Ecam-Eurobot/Eurobot-2017/doc/assets/Capture d’écran 2017-05-08 à 02.06.36.png

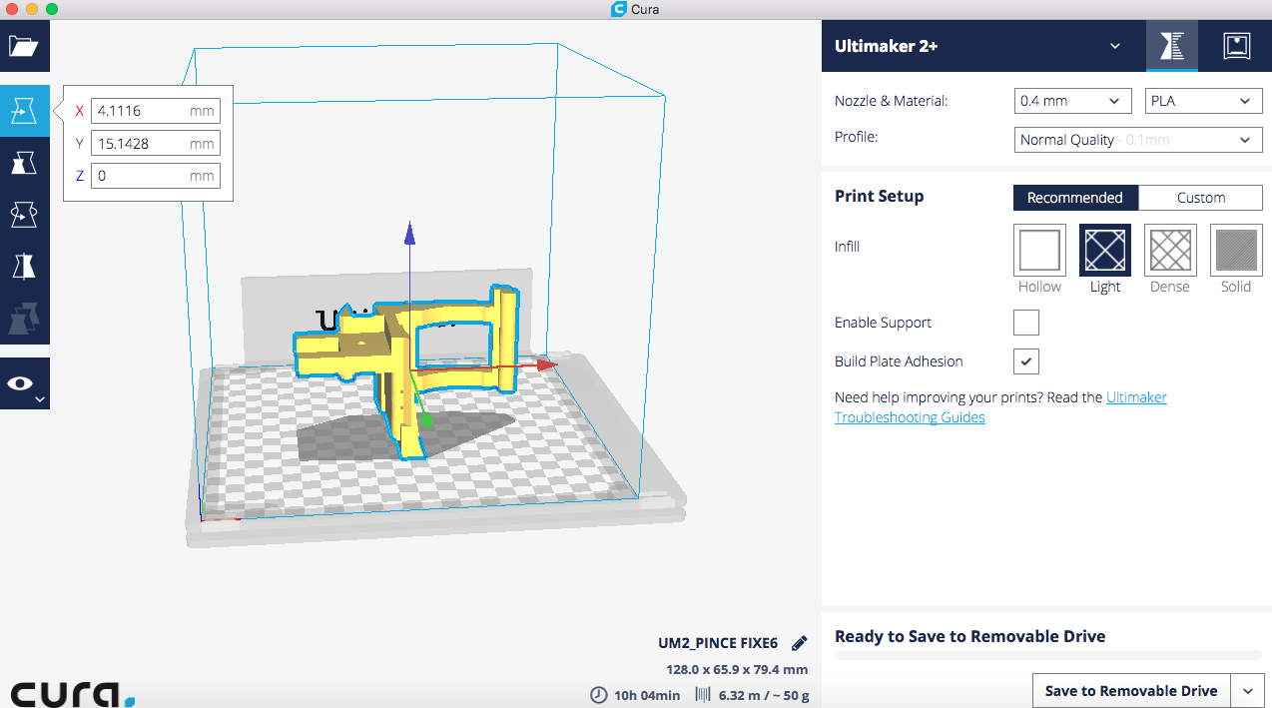
doc/assets/Capture d’écran 2017-05-08 à 02.06.36.png
