Ecam-Eurobot/Eurobot-2017/(threads)

Thread 5 (2017-02-02):

Interface I2C capteurs ultrasons

azerupi, 2017-02-02:
Il faut définir une interface (protocole / API) pour que la Raspberry Pi et l'Arduino, qui communiquent en I2C, puisse se comprendre.

**Cahier des charges**
- Demander la mesure de tout les capteurs en une fois
- Demander la mesure d'un capteur spécifique
- Si le capteur demandé n'existe pas, renvoyer une séquence d'erreur que la Raspberry peut comprendre
- Demander d'énumérer les capteurs qui existent
- *Autres?*

### Proposition

La Raspberry Pi envoie une instruction sur un byte contentant 2 parties codées sur 4 bits:
- La commande
- L'index du capteur (si applicable)

**commandes**
```
0001 xxxx        demander la mesure du capteur `xxxx`
0010 0000        demander la mesure de tous les capteurs
0011 0000        demander d'énumérer tous les capteurs
```

L'Arduino renvoie:
1. Une distance en cm (`int 16 bits`). On sépare le int en 2 bytes pour l'envoyer par I2C et puis on le reassemble sur la Pi. Si une erreur survient (e.g. le capteur n’existe pas) on renvoie `0xFFFF`.
2. n-fois 2 bytes (une fois par capteur)
3. n-fois 1 byte avec l'indice du capteur. On pourrait coder 2 capteurs par byte, mais alors il faut gérer le cas d'un nombre impaire de capteurs.

Ceci n'est qu'une proposition, la discussion est ouverte pour d'autres alternatives.

charlesvdv, 2017-02-02:
J'ai quelque pensée en plus à ajouter.

Valables pour toutes les communications I2C:
- Est-ce que la communication est 100% sans erreur ? (Il faudrait essayer d'envoyer des grosses séquences de bytes pour voir si on reçoit bien tout correctement) et donc ajouter un CRC ou un code de parité...

- N'enverrions nous pas la taille du message également dans le premier byte pour faciliter la gestion du module I2C sur la raspberry? (Pour avoir un tronc commun avec toutes les interfaces?)

- La communication sera d'office synchrone ? Aussi nn il faudrait réfléchir à ajouter la commande envoyée dans la requête.

Valables pour US:
- Lors de l'énumération de toutes les données des capteurs, ne faudrait il pas donner d'abord l'id du capteur pour ensuite mettre la valeur. On ajoute un peu d'overread mais on gagne en resiliance.

- C'est peut-être overkill mais possibiliter de demander certains capteurs genre que ceux avant ou arrière. Je sais pas si il y a un grand intérêt mais c's mieux d'y réfléchir mnt qu'après.

Aussi nn j'aime bien l'idee générale.

azerupi, 2017-02-02:
> Est-ce que la communication est 100% sans erreur ?

100% je ne sais pas. Mais, si je ne me trompe pas un appareil doit envoyer un bit de bonne réception ACK une fois un message reçu. Jusqu'à présent les seuls problèmes qu'on a eu avec l'I2C c'est des timeouts qui résultent en un exception dans la PI quand il y avait des mauvaises connexions ou que l'Arduino ne renvoyait pas ce qu'il fallait.

> N'enverrions nous pas la taille du message également dans le premier byte pour faciliter la gestion du module I2C sur la raspberry?

On pourrait, mais dépendant de ce qu'on doit envoyer ce n'est pas toujours nécessaire. Par exemple, pour les capteurs ultrason on a fini par demander une fois le nombre de capteurs présent à l'allumage et du coup on sait combien de bytes attendre en retour pour chaque requête. Ils faudra réfléchir par rapport aux besoins des autres modules.

> La communication sera d'office synchrone ?

Par synchrone tu veux dire que l'ordre est préservé? Alors oui, on écrit byte par byte sur le bus et pour chaque byte l’esclave envoi un bit de bonne réception.

>Nous devrions aussi ajouter une information sur l'erreur de l'arduino vu que la raspberry est la seul à logger les erreurs/warnings.

C'est pas une mauvaise idée, dans ce cas il faudra un peu réfléchir à ce qu'on a besoin précisément parce que je pense que le système décrit ci-dessus ne pourra pas le gérer.

> Lors de l'énumération de toutes les données des capteurs, ne faudrait il pas donner d'abord l'id du capteur pour ensuite mettre la valeur.

Quand on demande les mesures de tous les capteurs ont les reçoit dans l'ordre, donc envoyer l'ID n'as pas trop d’intérêt dans le setup actuel.

> C'est peut-être overkill mais possibiliter de demander certains capteurs genre que ceux avant ou arrière.

Je pense pas que ça vaut la peine de le gérer dans l'arduino, vu que la Pi peut demander les résultats d'un capteur précis il suffit de rajouter une méthode dans le code Python qui demande plusieurs capteurs précis.

JonathanPetit, 2017-02-02:
> Est-ce que la communication est 100% sans erreur ?

Il faudra faire attention lors du placement de la raspberry et de l'arduino dans la partie mécanique parce que si je me trompe pas l'i2c est fort perturbé par le bruit. Il faudra donc pas que la liaison entre les 2 soit trop longue.

> La communication sera d'office synchrone ?

Si je me trompe pas la communication i2c est d'office synchrone, en tout d'après ce que j'ai pu lire sur la différente documentation rencontré lorsque l'on tester l'i2c.

charlesvdv, 2017-02-03:
> Mais, si je ne me trompe pas un appareil doit envoyer un bit de bonne réception ACK une fois un message reçu.

Le fait qu'on envoie/reçoit un signal ACK ne signifie pas que les bits n'ont pas été modifié par la ligne de transmission. Il signifie juste que le récepteur a reçu qq chose.

Une autre chose à rajouter au protocole serait un simple ```ping pong``` pour être sûr que l'arduino est connectée.

Une chose où l'on devrait faire attention serait d'avoir un tronc commun important entre les différents protocoles I2C.

azerupi, 2017-02-04:
>Une autre chose à rajouter au protocole serait un simple ping pong pour être sûr que l'arduino est connectée.

Si elle n'est pas connectée, la librairie SMBus renvoie une exception, donc pas besoin de faire un ping. Par contre il faudra bien gérer les exceptions pour éviter que notre robot plante parce qu'il y à un mauvais branchement...

> Une chose où l'on devrait faire attention serait d'avoir un tronc commun important entre les différents protocoles I2C.

Dans #4 on a déjà commencé à faire exactement ça. En fonction des besoins des autres modules on pourra regrouper d'autres fonctionnalités sous la classe `I2C` pour éviter de se répéter.

Thread 6 (2017-02-07):

Interface I2C gestion moteur

charlesvdv, 2017-02-07:
Ce qu'on a besoin comme action:
- tourner à gauche de X degrés
- tourner à droite de X degrés
- avancer de X cm
- reculer de X cm
- arreter les moteurs
- demander le déplacement déjà effectuer
- demander si action finie ou pas

On a pas de précision de plus d'un cm donc ca sert à rien d'envoyer des données en dizaines de mm ou memes en minimètres. On aura donc besoin de 8bits pour avoir 256cm max (résonnable sachant que le plateau fait 1m*2m).

On peut donc faire un peu comme #5 mais la commande sera sur 8bits.

L'info sur le déplacement déjà effectué devra retourner 2 bytes. Un pour la roue gauche et un pour la roue droite.

@azerupi d'autres idées ?

azerupi, 2017-02-07:
>On a pas de précision de plus d'un cm

Même les odomètres?

Sinon au niveau des actions, ça me semble bien. Il y à juste une chose très importante qui manque, c'est la régulation de la vitesse :wink:

Soit on permet d'envoyer la vitesse comme paramètre pour chaque commande qui occasionne un déplacement, soit on rajoute une commande qui permet de changer la vitesse pour les commandes qui vont suivre.

Je dirais que les actions listés ci-dessus sont le stricte minimum à supporter, mais si on est chaud il y à moyen d'en ajouter des plus complexes qui permettraient d'avoir plus de mobilité et un déplacement plus fluide et donc plus rapide. On pourrait penser à:

- **Tourner en avançant**, au lieu d'avancer, s’arrêter pour tourner, avancer, s'arrêter à nouveau pour tourner, ... ça pourrait être plus efficace de pouvoir suivre une trajectoire courbe sans s’arrêter. Pour ça on devrait ralentir une roue par rapport à l'autre et bien réguler les vitesses.
- **Tourner autour d'une roue**, au lieu de tourner autour du centre, on pourrait vouloir tourner autour d'une des roues. Donc au lieu d'avoir les deux roues qui tournent dans un sens opposé, on aurait une roue à l'arrêt et une roue en mouvement.

Dernière chose, mais peut-être que je m'avance un peu trop, il faudra faire attention aux "accélération instantanées". Les moteurs sont vraiment costaud, si on passe de 0 à 100% en un coup on risque de faire basculer le robot. Je pense qu'il faudra faire en sorte que l'accélération se fasse progressivement.

charlesvdv, 2017-02-07:
> Même les odomètres?

D'après M. Marchand, une précision de 1cm est déjà très bien malheureusement parce qu'on doit compter aussi sur la précision des moteurs, etc

> Soit on permet d'envoyer la vitesse comme paramètre pour chaque commande qui occasionne un déplacement, soit on rajoute une commande qui permet de changer la vitesse pour les commandes qui vont suivre.

Je pense pas que ce soit utile vu que l'on a toujours comme but d'aller le plus rapidement possible. Par contre une commande spéciale pour passer la bascule pourrait etre intéressante.

> Dernière chose, mais peut-être que je m'avance un peu trop, il faudra faire attention aux "accélération instantanées". Les moteurs sont vraiment costaud, si on passe de 0 à 100% en un coup on risque de faire basculer le robot. Je pense qu'il faudra faire en sorte que l'accélération se fasse progressivement.

C'est le but de l'arduino avec la [régulation PID](https://en.wikipedia.org/wiki/PID_controller) que l'on doit incorporer.

> Je dirais que les actions listés ci-dessus sont le stricte minimum à supporter, mais si on est chaud il y à moyen d'en ajouter des plus complexes qui permettraient d'avoir plus de mobilité et un déplacement plus fluide et donc plus rapide.

D'après M. Marchand, aucune équipe de l'ECAM n'a jamais implémenté ca. Ca risque d'etre fort compliqué sachant que l'on a besoin du rayon de courbure de la trajectoire. Cette curbure pourrait etre non constante, etc... A voir mais pour moi il y a bcp plus important.

azerupi, 2017-02-07:
Oui, clairement il y à plus important. Je ne voulait pas dire qu'il fallait l'implémenter, mais plutôt qu'on pouvait structurer le code de façon à pouvoir l'ajouter plus tard, au cas ou. Même si on ne le fait pas cette année, on pourrait reprendre le code l'année prochaine et l'étendre par exemple. Autant pas s'imposer des limites quand elle ne sont pas nécessaires :)

> Je pense pas que ce soit utile vu que l'on a toujours comme but d'aller le plus rapidement possible. Par contre une commande spéciale pour passer la bascule pourrait etre intéressante.

Je suis pas tout à fait d'accord, en approchant des "destinations cibles" on voudra probablement ralentir pour être plus précis. On en aura également besoin pour la bascule et peut-être si jamais on tombe sur un obstacle imprévu (e.g. le robot adverse). Autant l'ajouter, je ne pense pas que ça ajoute beaucoup de complexité.

Thread 7 (2017-02-07):

Structure du programme raspi

charlesvdv, 2017-02-07:
Discussion pour la structure du code de RaspberryPi.

On doit gérer différentes parties:
- [x] une classe d'abstraction d'I2C (en cours via #4)
- [x] une classe qui gère les capteurs US (en cours via #4)
- [ ] une classe qui fait l'interface entre la commande et l'arduino *moteur*
- [ ] une classe de Logging
- [ ] une classe qui gère l'arduino *Cinématique* (action spécial faite par le robot genre ramasser des modules lunaires, funny actions, ramasser le balle lunaire??)(ou 2 classes pour le grand robot et le petit robot, peut etre plus facile)
- [ ] une classe qui gère le robot avec toutes les abstractions et les stratégies (on verra ca plus tard...)
- [ ] une classe qui gére la représentation des objets sur le terrain, la position du robot, ... Ca permettera d'avoir une abstraction sur le fait qu'on soit ou pas d'un coté ou d'un autre, etc
- [ ] une classe *PathFinder* pour calculer son chemin par rapport à la carte et sa position

(les taches sont mises plus ou moins en ordre d'importance)

Qq'un a encore une idée?

azerupi, 2017-02-07:
>ou 2 classes pour le grand robot et le petit robot, peut etre plus facile

Comme on est sur une machine linux, on peut utiliser une variable d’environnement pour choisir si on est sur le grand ou le petit robot. Alors on peut faire un seul code qui gère tout et en fonction de la Raspberry sur laquelle on l’exécute il changera son comportement. Je ne suis pas 100% sur que le code sera plus propre que si on scinde le programme en deux, mais je pense que c'est une piste à explorer.

> une classe qui gère l'arduino Cinématique

Je pense qu'il faut une classe par module. Par exemple, pour le gros robot, il aura un système pour attraper les cylindres, un pour les déposer et les retourner. Il est possible qu'on décide que ce soit trois modules séparés ou un seul module unique (à décider quand on aura une idée plus concrete). Mais pour moi, il faut au moins une classe par Arduino (module) qui crée une abstraction pour l'envoie de commande par I2C. Après, il y à moyen de grouper plusieurs de ces classes qui sont sensés fonctionner ensembles pour créer une abstraction de plus haut niveau par dessus.

Dans un premier temps, je pense qu'on doit se concentrer sur le code qui gère le hardware et éviter de trop réfléchir au code pour l'intelligence. Une fois que le hardware est bien représenté dans le code on pourra déjà tester le robot (si la partie mécanique et électronique suit).

charlesvdv, 2017-02-07:
> Comme on est sur une machine linux, on peut utiliser une variable d’environnement pour choisir si on est sur le grand ou le petit robot.

J'y avais aussi pensé aussi.

> Je pense qu'il faut une classe par module.

Je suis bien d'accord mais certaines actions de la cinématique ne demande pas la raspberry pi. La plus part du temps, la cinématique pensée ne requierera pas la raspberrypi.

> je pense qu'on doit se concentrer sur le code qui gère le hardware et éviter de trop réfléchir au code pour l'intelligence.

Ce n'est qu'une piste de rélfexion pour pouvoir démarrer le code raspberry pi plus rapidement comme le projet va avancer très vite maintenant que l'on est tous présents.

azerupi, 2017-02-08:
> une classe de Logging

J'imagine qu'on utilisera le module de logging standard de python. Probablement pas besoin de classe personnalisée.

Thread 8 (2017-02-08):

Fonctions communes arduino pour I2C

azerupi, 2017-02-08:
Je pense que, comme pour la Pi, il serait intéressant de mettre en commun certaines fonctions pour la gestion de l'I2C pour les arduinos. Comme les arduinos sont plus bas niveau et spécifique, on n'as pas nécessairement besoin d'une abstraction tel que sur la Pi. Mais les fonctions pour la construction / déstructuration des messages I2C pourrait servir pour la plupart des modules.

Thread 11 (2017-02-21):

Protocole I2C pour la gestion des servos

gaeta1611, 2017-02-21:
# Cahier de charge

- Envoyer à quel servo veut-on parler
- Envoyer une action pour ce servo (open/close - up/down)
- Demander si le déplacement est fini ou pas
- Arrêter le mouvement des servos
- Autre ?

Besoin de 7-8 bits (à définir) pour envoyer l'angle (valeur entre 0 et 180, mais jusque 180 vraiment nécessaire ?).

Besoin de 2 bits pour définir à quel servo on parle. (3-4 servo différents maximum)

Reste des actions à définir.

Thread 13 (2017-02-22):

UML Raspberry

JonathanPetit, 2017-02-22:
Uml complet du projet eurobot 2017. Réfléchis par Charles et moi-même.
Suggestions ou corrections dites le nous.
@azerupi Qu'en penses-tu?

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

azerupi, 2017-02-23:
En reprenant les classes que nous avons déjà pour les modules I2C, personellement je commencerais par étendre comme ceci:

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

L'idée c'est d'avoir une classe `Robot` qui contrôle le robot à un haut niveau (éventuellement cette classe pourrait aussi avoir la routine principale, e.g. `run`). Cette classe contiendrait les différents modules qu'on à implémenté (capteurs, moteurs, pinces, ...) et fournit les méthodes de plus haut niveau.

Il contiendrait également une classe `Map` qui gère la position des différents obstacles et le pathfinding. Je pense qu'un map en tant qu'array 2D va être beaucoup trop coûteux. Il y à moyen de fortement s'inspirer des algorithmes et représentations utilisés pour les jeux. J'avais pensé à travailler simplement avec des listes de coordonnées cartésiennes et des calculs de "bounding box" pour les obstacles, mais il faut voir si ça fonctionne pour le pathfinding. Je pense qu'on peut ouvrir une issue rien que pour discuter de ça :yum:

charlesvdv, 2017-02-24:
En reparlant avec M. Marchand, les différentes stratégies n'ont pas d'interets si on a un algorithme de recherche de chemin performant pour faire volte-face si on a un obstacle. Du coup je suis d'accord que ca n'a pas d'intéret d'avoir des classes ```HighLevelAction``` et ```Strategy``` et mettre tout dans la classe ```Robot```.

Concernant la map, j'ai trouvé un truc vraiment pas mal... C's un [navigation meshes](http://theory.stanford.edu/~amitp/GameProgramming/MapRepresentations.html#navigation-meshes) qui représente les chemins possibles par un graphe. Ca a l'air d'être la solution la plus optimal.

On pourrait également avoir des meshes avec différentes zones pour par exemple limiter la vitesse(bascule), etc...

Je pense également qu'il serait intéressant d'avoir des nodes spécifiques comme atouts où il pourrait avoir des contraintes d'angles pour arriver sur l'objet, etc... et de laisser les obstacles abstraits (sans avoir de types précis) pour avoir plus de flexibilité pour les années d'après.

Thread 14 (2017-03-02):

raspberrypi info

charlesvdv, 2017-03-02:
*Ceci est une note. Ne pas la fermer*

#### IP
``` 172.17.33.174 ```
*Devrait normalement être statique... A voir*

#### login
```pi```

#### password
```raspberry```

Thread 17 (2017-03-31):

TODO grand robot pour concours!

charlesvdv, 2017-03-31:
## Mécanique
- [ ] funny action
- [ ] finir pince
- [ ] attacher la batterie
- [ ] modifier le belier + ajouter calle
- [ ] tester angle servo
- [ ] checker pente toboggan/pince
- [ ] finiolage
- [ ] fixer les US

## Code
- [ ] régul
- [ ] path finding
- [ ] gerer les actions haut level
- [ ] gerer les obstacles dynamiques
- [ ] mettre tout ensemble

Thread 29 (2017-05-18):

Année 2018 - Amélioration du système de contrôle des moteurs

AlexisTM, 2017-05-18:
Afin d'améliorer le système de contrôle des moteurs, il est nécessaire de calculer la position du robot plutôt que de penser qu'il est arrivé. Il y aura toujours un certain drift, mais il se fera probablement que peu sentir sur 90 secondes.

Voici l'idée:

Variables globales:

```
double distance_between_wheels = 0.4; // in meters
double x = 0;
double y = 0;
double th = 0; // Th est aussi appelé heading, théta ou yaw
unsigned long last_computation = micros();
```

Boucle de calcul, à executer toutes les N millisecondes

```
loop every N milliseconds
    double dt = (micros() -  last_computation)/1000000.0; // Temps depuis le calcul précédent

    // Vitesses en m/s
    double v_right = speed_right_wheel;
    double v_left = speed_left_wheel;

    // vx : Vitesse frontale - m/s
    // vy : Vitesse latérale - m/s
    // vth : Vitesse angulaire (autour de z) - radians/s
    double vx = (v_right + v_left)/2;
    double vy = 0
    double vth = (v_right - v_left) / distance_between_wheels;

    // Calculons la différence de position du robot (rotation)
    double delta_x = (vx * cos(th) - vy * sin(th)) * dt;
    double delta_y = (vx * sin(th) + vy * cos(th)) * dt;
    double delta_th = vth * dt;

    x = x + delta_x; // m
    y = y + delta_y; // m
    th = th + delta_th; // radians
```

Il est ensuite facile de calculer l'erreur de position et l'erreur angulaire pour la régulation.

```
ErrorX = setpoint.x - CurrentPosition.x
ErrorY = setpoint.y - CurrentPosition.y

# Error in forward direction of the robot
ErrorX_f = (cos(CurrentPosition.yaw) * ErrorX) + (sin(CurrentPosition.yaw) * ErrorY);
ErrorY_f = (-sin(CurrentPosition.yaw) * ErrorX) + (cos(CurrentPosition.yaw) * ErrorY);

ErrorTh = ErrorYaw = atan2( ErrorY_f, ErrorX_f)
```

charlesvdv, 2017-05-22:
@AlexisTM quel est l'avantage de cette approche par rapport à l'utilisation des odomètres qui sont pour l'instant sur le robot ? Ton idée est en fait de créer un système [INS](https://en.wikipedia.org/wiki/Inertial_navigation_system) ?

Les vitesses ```v_right``` et ```v_left``` ne peuvent être optenue *(pour l'instant en tout cas)* qu'en dérivant notre valeur de position sur un interval ```dt``` et ta manière consiste juste à intégré ces vitesses pour avoir la position. Nous revenons donc à notre point de départ et vu que la régulation change toutes les ```10ms``` les consignes de vitesse, cela signifie que l'on va perdre en précision dans notre positionnement.

AlexisTM, 2017-05-22:
C'est exactement ça. Tu utilises les odomètres pour déterminer les vitesses de chaque roue et obtenir la position.

En effet, il y a un drift, qui est inévitable, mais au final, tu gagneras en précision. En effet, en ne se basant que sur les odomètres, tu as une bonne précision localement mais globalement tu perds beaucoup de précision en "estimant être arrivé". Je te propose très simplement de mettre ce code côte à côte avec la régulation actuelle et observe le drift de la position. Sur 90 secondes et de si petites distances, ce sera minime.

De plus, réaliser la régulation de cette façon permet de faire un fusion de senseurs plus simple, par exemple en mettant un IMU et en utilisant un [Extended Kalman Filter](https://github.com/cra-ros-pkg/robot_localization)

Sur l'Arduino, la régulation bas niveau reste primordiale afin d'obtenir une vitesse correcte sur chacun des moteurs.

AlexisTM, 2024-10-28:
Outdated.

Closed 2024-10-28.
