Ecam-Eurobot/Eurobot-2017/(commit log)

2017-02-01 First design to abstract I2C comm behind a class
2017-02-02 Improve I2C abstraction
2017-02-03 [WIP] first arduino code for ultrason capteur
2017-02-08 Resolve bugs and format arduino code
    [i2c.py, range_sensors.py, us_sensors.ino]
2017-02-09 Ajout du rapport de l'année passée dans la doc.
2017-02-10 Fix errors in the python code
    [i2c.py, range_sensors.py]
2017-02-14 Controle basique des moteurs
2017-02-14 Ajout interface moteur pour la raspberrypi
2017-02-14 Implementation I2C communication
2017-02-16 fix motor control
2017-02-16 move motors.ino
2017-02-16 Fixe du array non valide
    [motors.ino]
2017-02-17 add motor abstraction
2017-02-17 fix compilation error for motors
    [motor.cpp, motor.h, motors.ino]
2017-02-17 add regulation for the motors
2017-02-19 finish regulation and Arduino I2C communication part
2017-02-20 cleanup and update raspberrypi code
    This commit marks also the first lead regulation working!
2017-02-21 Adding Dynamixel/servo ino code and librairy
2017-03-15 fix comments from @bluebeel
    mostly fix for const/constexpr
    [motor.cpp, motor.h, regulation.h]
2017-03-16 fix left right mismatch
    [motors.ino]
2017-03-18 Final version of Arduino servo
2017-03-18 Trouble shooting I2C dynamixel
2017-03-18 Adding the 2 others servo : Stack and push
2017-04-07 Finale version of Arduino SERVO
2017-04-07 Change servo push parameters
2017-04-12 handle OSError when I2C bus is busy.
2017-04-12 fix maxspeed motors control
    [motor.cpp, motor.h, regulation.cpp]
2017-04-12 correct pin for encoder
    [motors.ino]
2017-04-12 move us_sensors in his own folder
    the arduino IDE keep moving the file in his own folder so be it!
2017-04-12 update get_distance I2C command
    This will return the distance since the last call of the get_distance command since
    the regulation began. We should always check everytime the compilation is done the distance
    travelled.
2017-04-12 use more friendly output for US sensors
2017-04-12 fix syntax error in Robot class
    [robot.py]
2017-04-12 add script to connect to raspberrypi without internet connection
2017-04-24 fix signed int receiving and fix bug
    [i2c.py]
2017-04-24 fix motors handling
2017-04-24 fix formatting and add funny code
    [kinematics.py]
2017-04-24 resto Marchand
    this code was used for the Eurobot 2017. This doesn't include the pathfinding
    as the time limit was too short. The code may be a bit awful sorry for that.
    [hardcode.py, robot2.py]
2017-04-26 Troubleshoot us sensor
2017-04-26 Cleaning arduino us_sensor comments
2017-04-26 Adding servo, i2c, protocols and us sensor documentation
2017-04-26 add doc for int function from i2c.py
2017-05-09 Lorenzo's documentation about power supply
